DavidMolTor/ValkiriaSplit/Hardware/ValkiriaSplit.kicad_pcb

## KiCad design Hardware/ValkiriaSplit.kicad_pcb (2026-11-13)

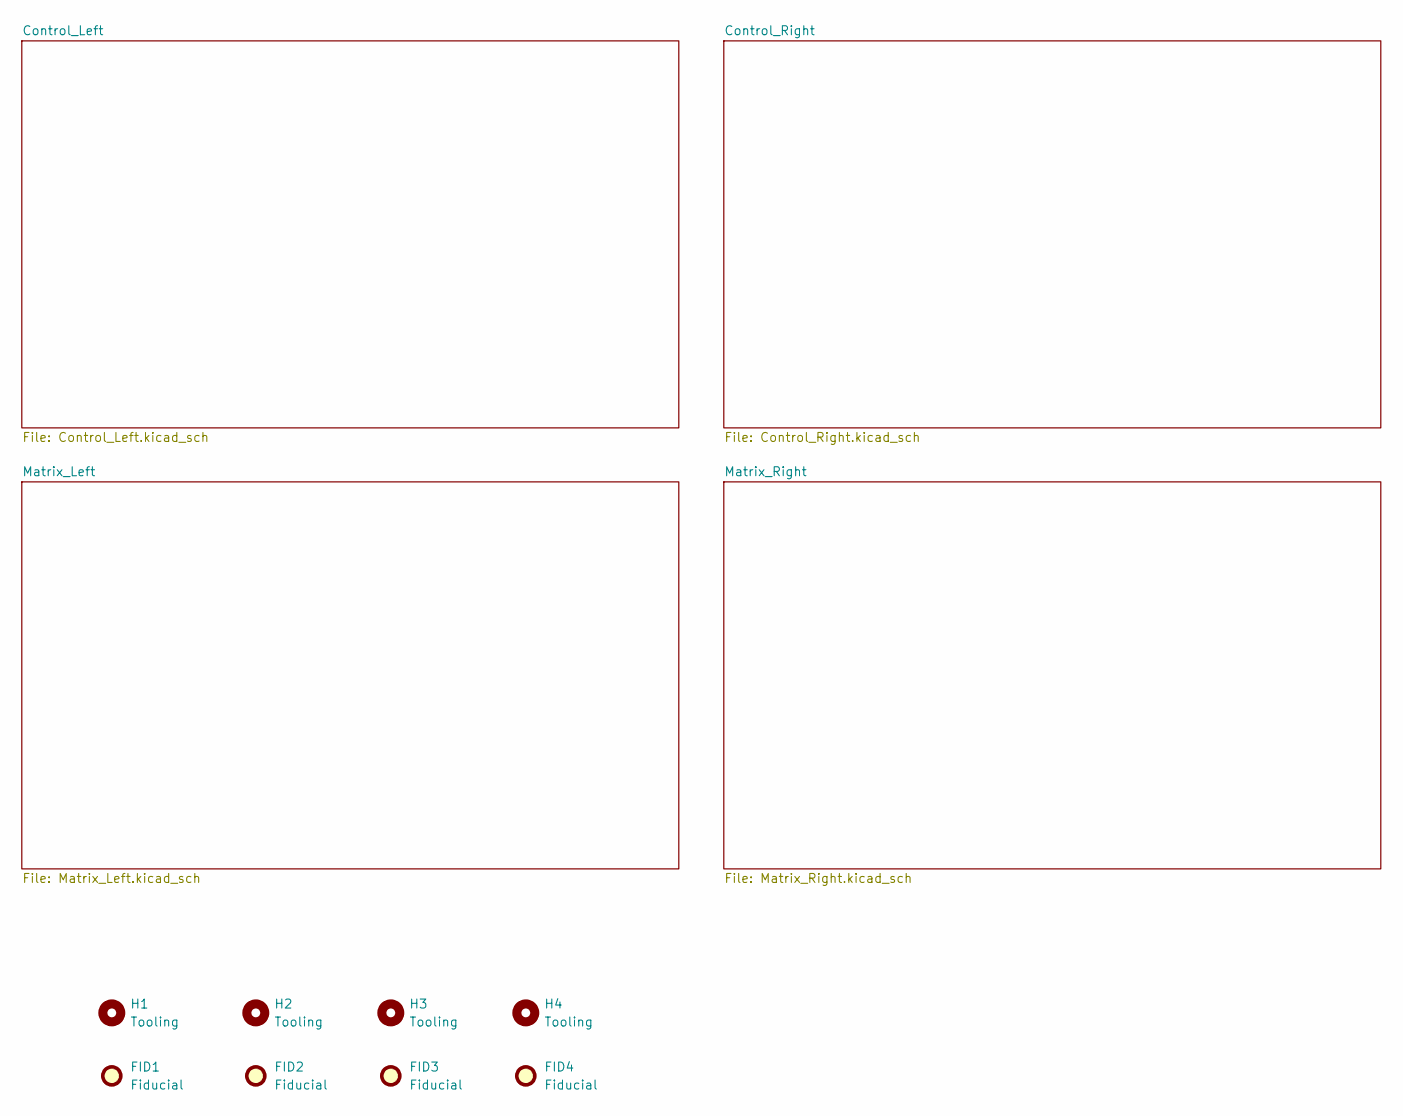
[picture p2: schematic ValkiriaSplit.kicad_sch, VALKIRIA SPLIT]

Parts:
FID1, FID2, FID3, FID4: Fiducial; Fiducial_1mm_Mask2mm
H1, H2, H3, H4: Tooling; ToolingHole_1.152mm

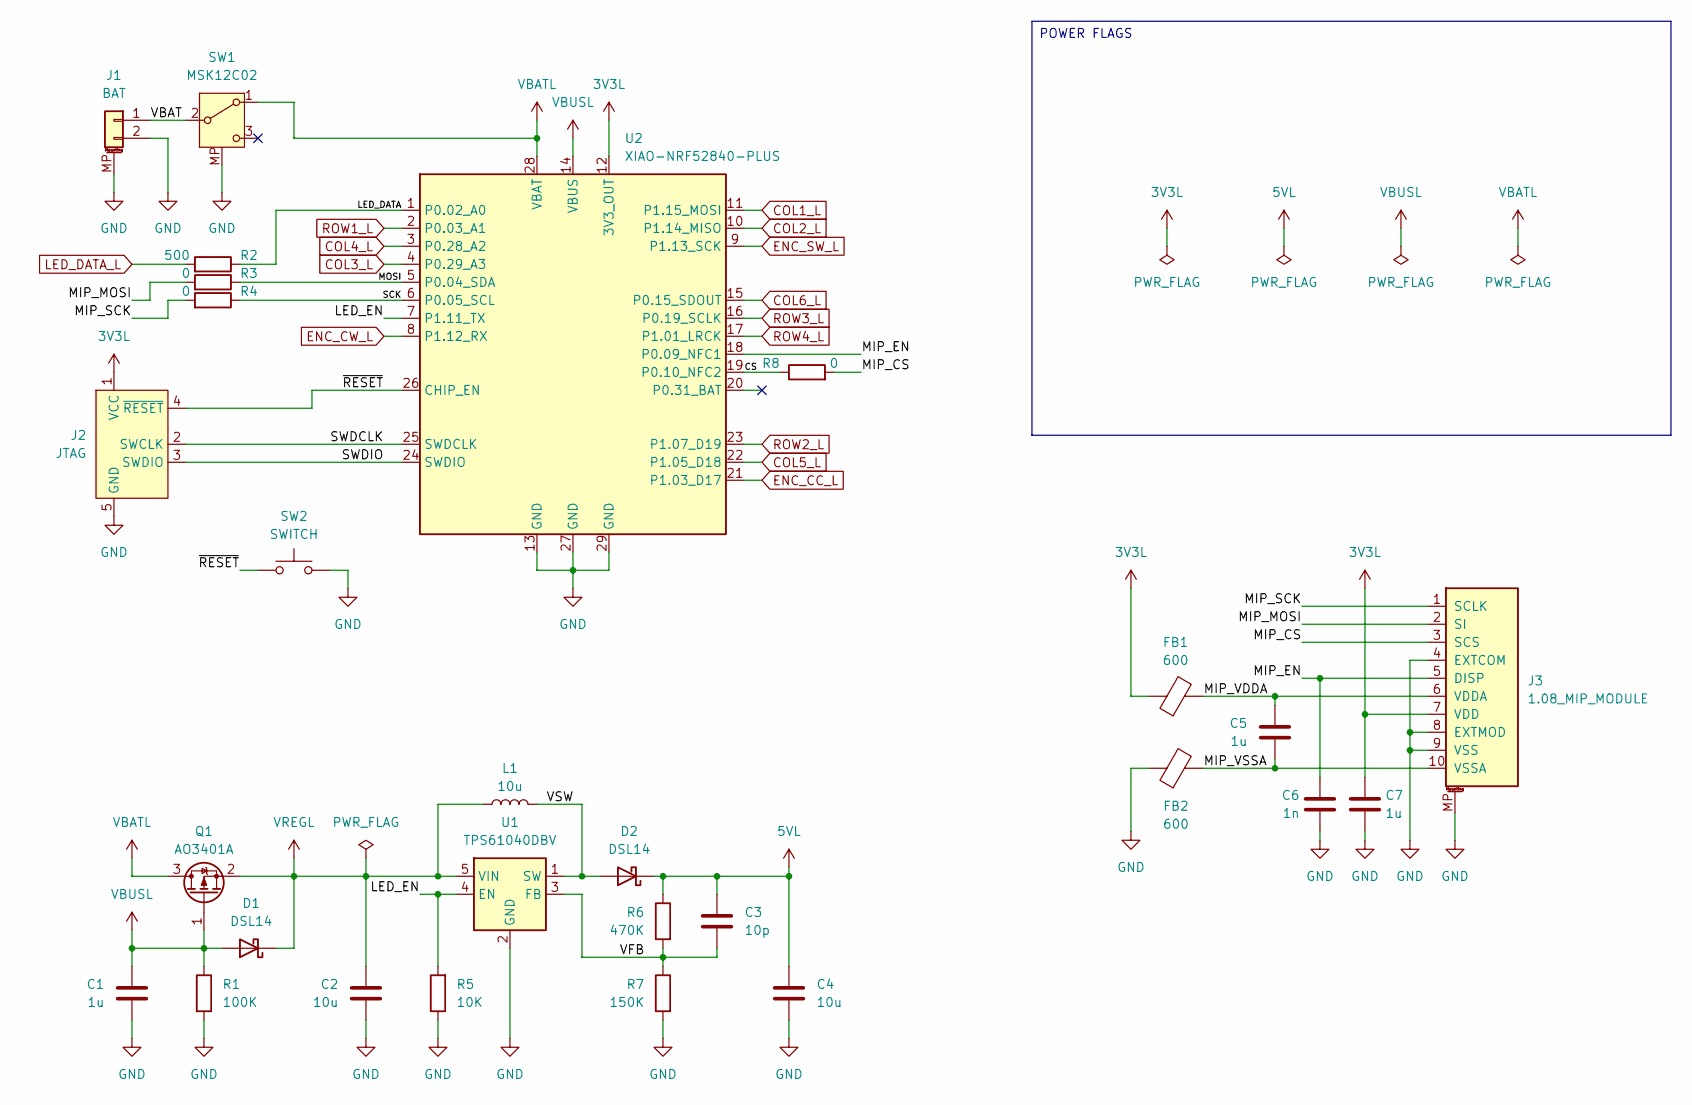
[picture p3: schematic Control_Left.kicad_sch, VALKIRIA SPLIT]

Parts:
C1, C5, C7: 1u; C_0603_1608Metric; Manufacturer Part CL10A105KB8NNNC; JLC Part C15849
C2, C4: 10u; C_0603_1608Metric; Manufacturer Part CL10A106MA8NRNC; JLC Part C96446
C3: 10p; C_0603_1608Metric; Manufacturer Part CL10C100JB8NNNC; JLC Part C1634
C6: 1n; C_0603_1608Metric; Manufacturer Part CL10B102KB8NNNC; JLC Part C1588
D1, D2: DSL14; D_SOD-123F; Manufacturer Part DSL14; JLC Part C22466349
FB1, FB2: 600; L_0603_1608Metric; Manufacturer Part GZ1608D601TF; JLC Part C1002
J1: BAT; JST_ZH_1x02_P1.50MM_SMD_HORIZONTAL; Manufacturer Part ZH1.5-2P-WT; JLC Part C722913
J2: JTAG; JTAG_SWD_1X05_1.27MM_COMBO
J3: 1.08_MIP_MODULE; 1.08_MIP_MODULE_TALL; Manufacturer Part AFC07-S10FCC-00; JLC Part C11050
L1: 10u; VLCF4020_MIRROR; Manufacturer Part NRS4018T100MDGJ; JLC Part C222882
Q1: AO3401A; SOT-23; Manufacturer Part AO3401A; JLC Part C15127
R1: 100K; R_0603_1608Metric; Manufacturer Part 0603WAF1003T5E; JLC Part C25803
R2: 500; R_0603_1608Metric; Manufacturer Part 0603WAF0000T5E; JLC Part C21189
R3, R4, R8: 0; R_0603_1608Metric; Manufacturer Part 0603WAF0000T5E; JLC Part C21189
R5: 10K; R_0603_1608Metric; Manufacturer Part 0603WAF1002T5E; JLC Part 0603WAF1002T5E
R6: 470K; R_0603_1608Metric; Manufacturer Part 0603WAF4703T5E; JLC Part C23178
R7: 150K; R_0603_1608Metric; Manufacturer Part 0603WAF1503T5E; JLC Part C22807
SW1: MSK12C02; Manufacturer Part MSK12C02-HB; JLC Part C431541
SW2: SWITCH; SW_SPST_TS-1088-xR020; Manufacturer Part TS-1088-AR02016; JLC Part C720477
U1: TPS61040DBV; SOT-23-5; Manufacturer Part TPS61040DBVR; JLC Part C7722
U2: XIAO-NRF52840-PLUS; XIAO-NRF52840-PLUS-SMD-EDGE

Connections:
3V3L: C7.1, FB1.1, J2.1 (VCC), J3.7 (VDD), U2.12 (3V3_OUT)
5VL: C3.1, C4.1, D2.1 (K), R6.1; also elsewhere on the board
/Control_Left/CS: R8.1, U2.19 (P0.10_NFC2)
/Control_Left/LED_DATA: R2.1, U2.1 (P0.02_A0)
/Control_Left/LED_EN: R5.2, U1.4 (EN), U2.7 (P1.11_TX)
/Control_Left/MIP_CS: J3.3 (SCS), R8.2
/Control_Left/MIP_EN: C6.1, J3.5 (DISP), U2.18 (P0.09_NFC1)
/Control_Left/MIP_MOSI: J3.2 (SI), R3.2
/Control_Left/MIP_SCK: J3.1 (SCLK), R4.2
/Control_Left/MIP_VDDA: C5.1, FB1.2, J3.6 (VDDA)
/Control_Left/MIP_VSSA: C5.2, FB2.2, J3.10 (VSSA)
/Control_Left/MOSI: R3.1, U2.5 (P0.04_SDA)
/Control_Left/SCK: R4.1, U2.6 (P0.05_SCL)
/Control_Left/SWDCLK: J2.2 (SWCLK), U2.25 (SWDCLK)
/Control_Left/SWDIO: J2.3 (SWDIO), U2.24 (SWDIO)
/Control_Left/VBAT: J1.1, SW1.2 (B)
/Control_Left/VFB: C3.2, R6.2, R7.1, U1.3 (FB)
/Control_Left/VSW: D2.2 (A), L1.2, U1.1 (SW)
/Control_Left/~RESET: J2.4 (~RESET), SW2.1, U2.26 (CHIP_EN)
COL1_L: U2.11 (P1.15_MOSI); also elsewhere on the board
COL2_L: U2.10 (P1.14_MISO); also elsewhere on the board
COL3_L: U2.4 (P0.29_A3); also elsewhere on the board
COL4_L: U2.3 (P0.28_A2); also elsewhere on the board
COL5_L: U2.22 (P1.05_D18); also elsewhere on the board
COL6_L: U2.15 (P0.15_SDOUT); also elsewhere on the board
ENC_CC_L: U2.21 (P1.03_D17); also elsewhere on the board
ENC_CW_L: U2.8 (P1.12_RX); also elsewhere on the board
ENC_SW_L: U2.9 (P1.13_SCK); also elsewhere on the board
GND: C1.2, C2.2, C4.2, C6.2, C7.2, FB2.1, J1.2, J1.MP (MountPin), J2.5 (GND), J3.4 (EXTCOM), J3.8 (EXTMOD), J3.9 (VSS), J3.MP, R1.2, R5.1, R7.2, SW1.MP, SW2.2, U1.2 (GND), U2.13 (GND), U2.27 (GND), U2.29 (GND); also elsewhere on the board
LED_DATA_L: R2.2; also elsewhere on the board
ROW1_L: U2.2 (P0.03_A1); also elsewhere on the board
ROW2_L: U2.23 (P1.07_D19); also elsewhere on the board
ROW3_L: U2.16 (P0.19_SCLK); also elsewhere on the board
ROW4_L: U2.17 (P1.01_LRCK); also elsewhere on the board
VBATL: Q1.3 (D), SW1.1 (A), U2.28 (VBAT)
VBUSL: C1.1, D1.2 (A), Q1.1 (G), R1.1, U2.14 (VBUS)
VREGL: C2.1, D1.1 (K), L1.1, Q1.2 (S), U1.5 (VIN)

Notes on the sheet:
POWER FLAGS

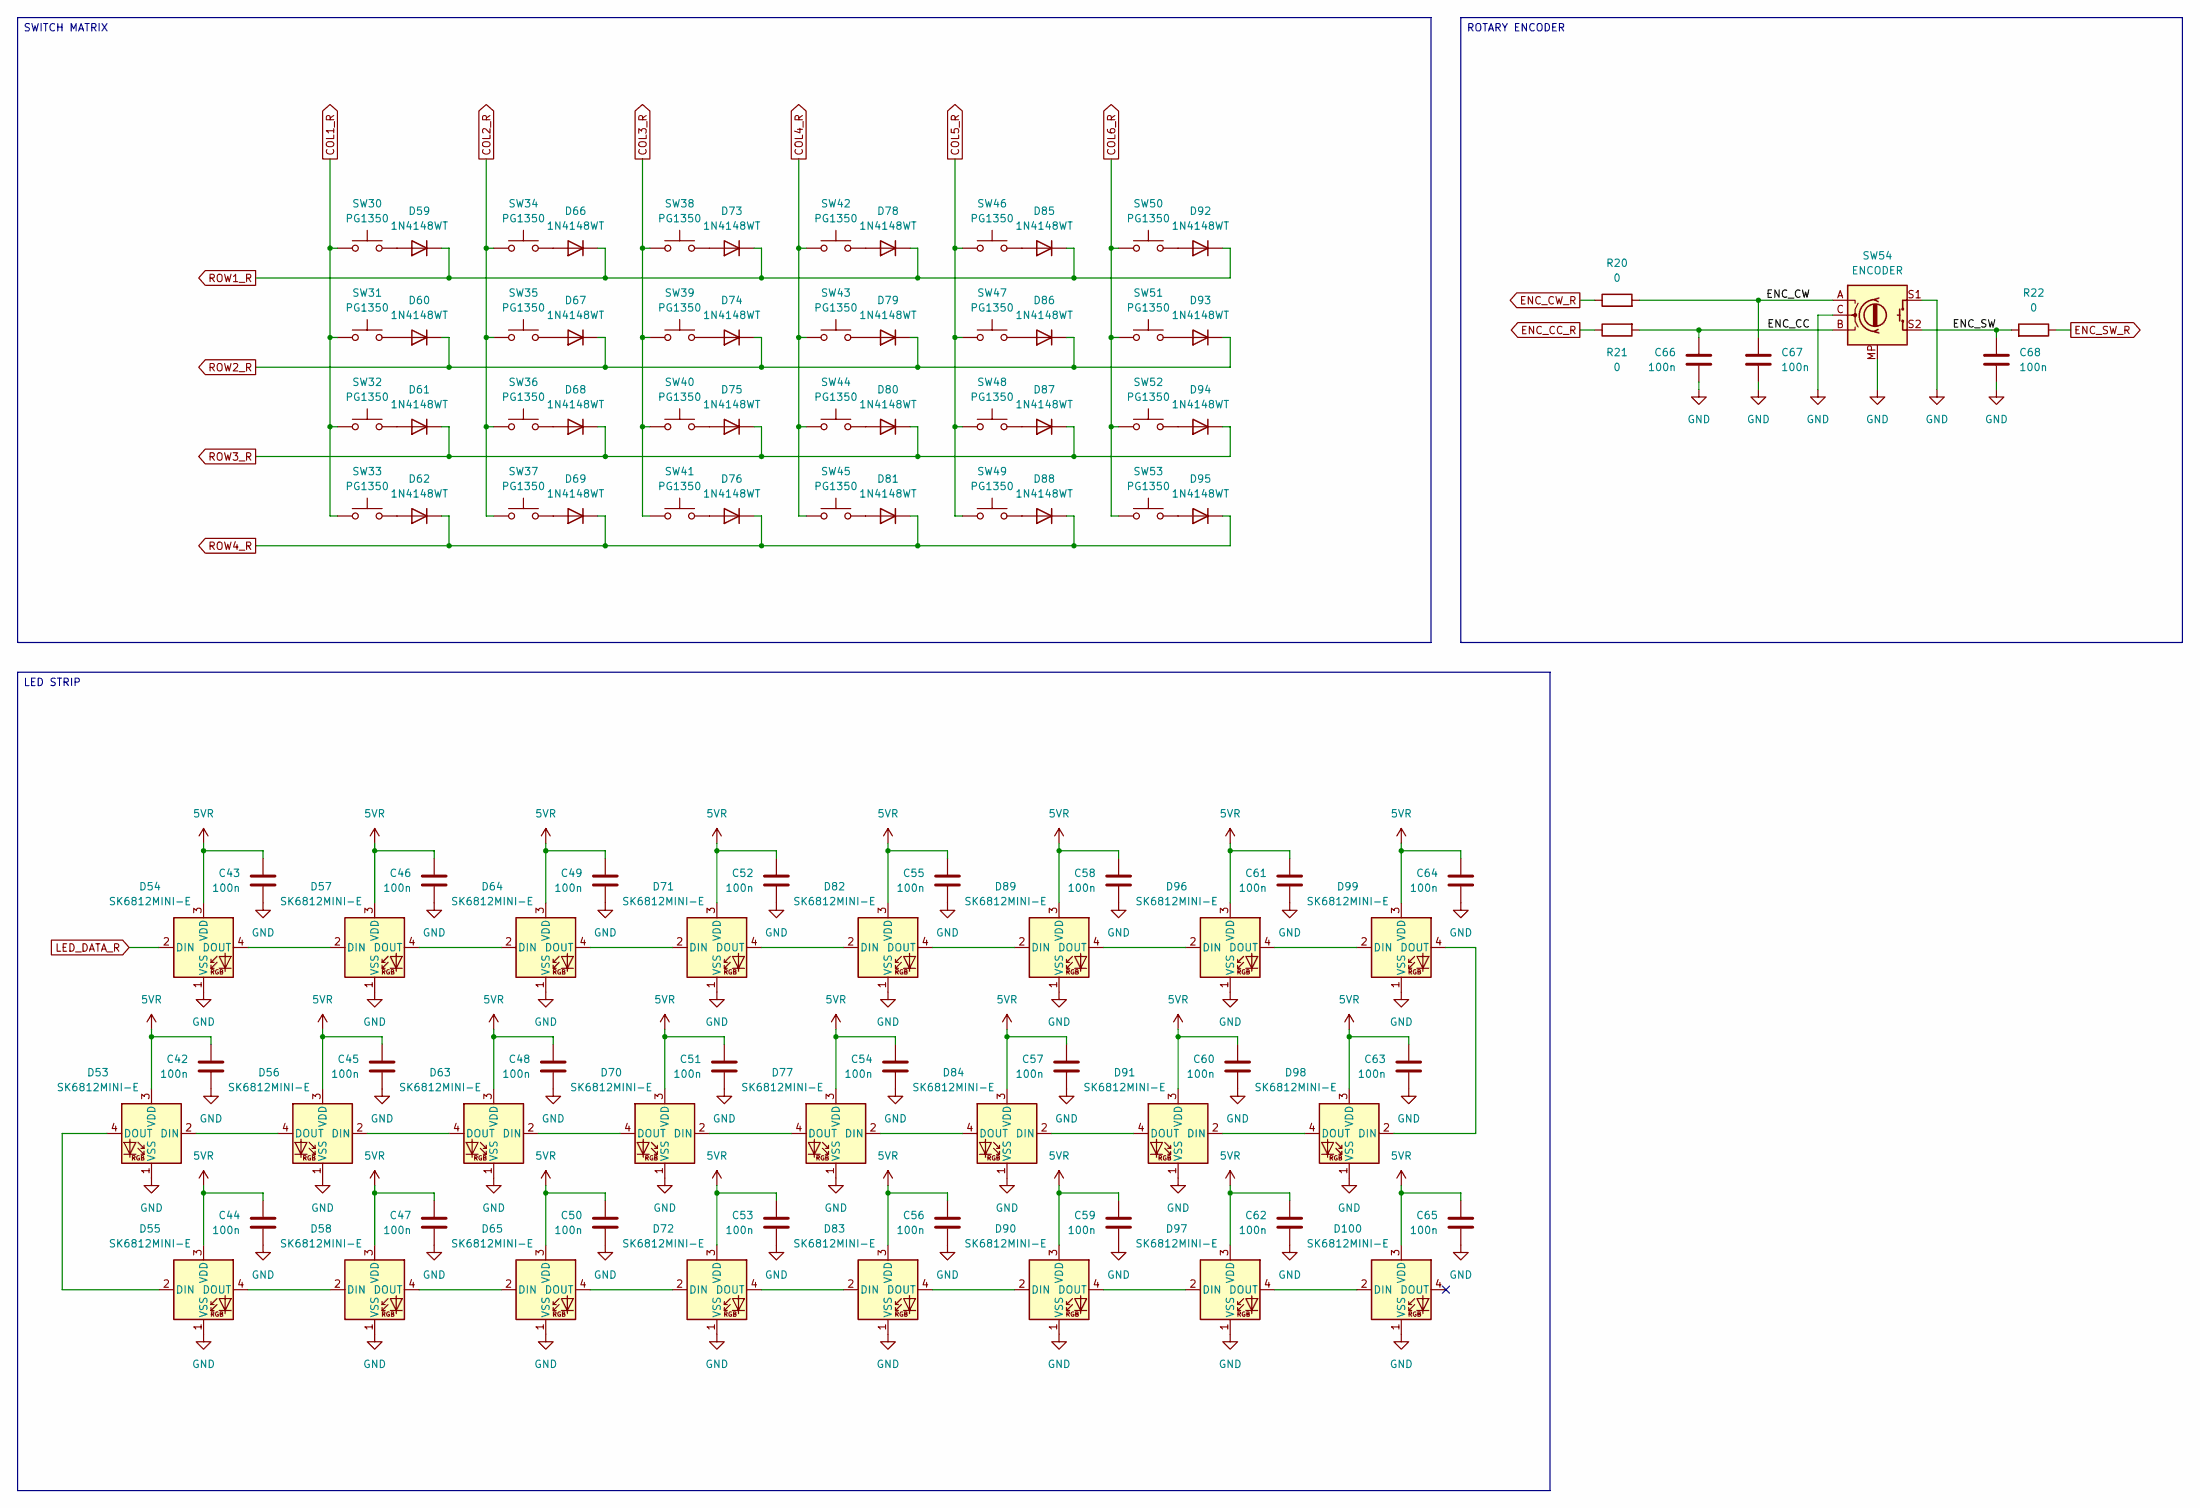
[picture p4: schematic Matrix_Right.kicad_sch, VALKIRIA SPLIT]

Parts:
C42, C43, C44, C45, C46, C47, C48, C49, C50, C51, C52, C53, C54, C55, C56, C57, C58, C59, C60, C61, C62, C63, C64, C65, C66, C67, C68: 100n; C_0603_1608Metric; Manufacturer Part CC0603KRX7R9BB104; JLC Part C14663
D53, D54, D55, D56, D57, D58, D63, D64, D65, D70, D71, D72, D77, D82, D83, D84, D89, D90, D91, D96, D97, D98, D99, D100: SK6812MINI-E; LED_SK6812MINI-E_3.2x2.8mm_P1.5mm_ReverseMount; Manufacturer Part SK6812MINI-E; JLC Part C5149201
D59, D60, D61, D62, D66, D67, D68, D69, D73, D74, D75, D76, D78, D79, D80, D81, D85, D86, D87, D88, D92, D93, D94, D95: 1N4148WT; D_SOD-523; Manufacturer Part 1N4148WT; JLC Part C7420320
R20, R21, R22: 0; R_0603_1608Metric; Manufacturer Part 0603WAF0000T5E; JLC Part C21189
SW30, SW31, SW32, SW33, SW34, SW35, SW36, SW37, SW38, SW39, SW40, SW41, SW42, SW43, SW44, SW45, SW46, SW47, SW48, SW49, SW50, SW51, SW52, SW53: PG1350; PG1350_1.00u_PCB_TIGHT; Manufacturer Part CPG135001S30; JLC Part C5333465
SW54: ENCODER; ALPS_EC11J_ENCODER; Manufacturer Part EC11J1525402; JLC Part C209762

Connections:
5VR: C42.1, C43.1, C44.1, C45.1, C46.1, C47.1, C48.1, C49.1, C50.1, C51.1, C52.1, C53.1, C54.1, C55.1, C56.1, C57.1, C58.1, C59.1, C60.1, C61.1, C62.1, C63.1, C64.1, C65.1, D53.3 (VDD), D54.3 (VDD), D55.3 (VDD), D56.3 (VDD), D57.3 (VDD), D58.3 (VDD), D63.3 (VDD), D64.3 (VDD), D65.3 (VDD), D70.3 (VDD), D71.3 (VDD), D72.3 (VDD), D77.3 (VDD), D82.3 (VDD), D83.3 (VDD), D84.3 (VDD), D89.3 (VDD), D90.3 (VDD), D91.3 (VDD), D96.3 (VDD), D97.3 (VDD), D98.3 (VDD), D99.3 (VDD), D100.3 (VDD); also elsewhere on the board
/Matrix_Right/ENC_CC: C66.1, R21.2, SW54.B
/Matrix_Right/ENC_CW: C67.1, R20.2, SW54.A
/Matrix_Right/ENC_SW: C68.1, R22.2, SW54.S2
COL1_R: SW30.1, SW31.1, SW32.1, SW33.1; also elsewhere on the board
COL2_R: SW34.1, SW35.1, SW36.1, SW37.1; also elsewhere on the board
COL3_R: SW38.1, SW39.1, SW40.1, SW41.1; also elsewhere on the board
COL4_R: SW42.1, SW43.1, SW44.1, SW45.1; also elsewhere on the board
COL5_R: SW46.1, SW47.1, SW48.1, SW49.1; also elsewhere on the board
COL6_R: SW50.1, SW51.1, SW52.1, SW53.1; also elsewhere on the board
ENC_CC_R: R21.1; also elsewhere on the board
ENC_CW_R: R20.1; also elsewhere on the board
ENC_SW_R: R22.1; also elsewhere on the board
GND: C42.2, C43.2, C44.2, C45.2, C46.2, C47.2, C48.2, C49.2, C50.2, C51.2, C52.2, C53.2, C54.2, C55.2, C56.2, C57.2, C58.2, C59.2, C60.2, C61.2, C62.2, C63.2, C64.2, C65.2, C66.2, C67.2, C68.2, D53.1 (VSS), D54.1 (VSS), D55.1 (VSS), D56.1 (VSS), D57.1 (VSS), D58.1 (VSS), D63.1 (VSS), D64.1 (VSS), D65.1 (VSS), D70.1 (VSS), D71.1 (VSS), D72.1 (VSS), D77.1 (VSS), D82.1 (VSS), D83.1 (VSS), D84.1 (VSS), D89.1 (VSS), D90.1 (VSS), D91.1 (VSS), D96.1 (VSS), D97.1 (VSS), D98.1 (VSS), D99.1 (VSS), D100.1 (VSS), SW54.C, SW54.MP, SW54.S1; also elsewhere on the board
LED_DATA_R: D54.2 (DIN); also elsewhere on the board
unnamed: D53.2 (DIN), D56.4 (DOUT)
unnamed: D53.4 (DOUT), D55.2 (DIN)
unnamed: D54.4 (DOUT), D57.2 (DIN)
unnamed: D55.4 (DOUT), D58.2 (DIN)
unnamed: D56.2 (DIN), D63.4 (DOUT)
unnamed: D57.4 (DOUT), D64.2 (DIN)
unnamed: D58.4 (DOUT), D65.2 (DIN)
unnamed: D59.2 (A), SW30.2
unnamed: D60.2 (A), SW31.2
unnamed: D61.2 (A), SW32.2
unnamed: D62.2 (A), SW33.2
unnamed: D63.2 (DIN), D70.4 (DOUT)
unnamed: D64.4 (DOUT), D71.2 (DIN)
unnamed: D65.4 (DOUT), D72.2 (DIN)
unnamed: D66.2 (A), SW34.2
unnamed: D67.2 (A), SW35.2
unnamed: D68.2 (A), SW36.2
unnamed: D69.2 (A), SW37.2
unnamed: D70.2 (DIN), D77.4 (DOUT)
unnamed: D71.4 (DOUT), D82.2 (DIN)
unnamed: D72.4 (DOUT), D83.2 (DIN)
unnamed: D73.2 (A), SW38.2
unnamed: D74.2 (A), SW39.2
unnamed: D75.2 (A), SW40.2
unnamed: D76.2 (A), SW41.2
unnamed: D77.2 (DIN), D84.4 (DOUT)
unnamed: D78.2 (A), SW42.2
unnamed: D79.2 (A), SW43.2
unnamed: D80.2 (A), SW44.2
unnamed: D81.2 (A), SW45.2
unnamed: D82.4 (DOUT), D89.2 (DIN)
unnamed: D83.4 (DOUT), D90.2 (DIN)
unnamed: D84.2 (DIN), D91.4 (DOUT)
unnamed: D85.2 (A), SW46.2
unnamed: D86.2 (A), SW47.2
unnamed: D87.2 (A), SW48.2
unnamed: D88.2 (A), SW49.2
unnamed: D89.4 (DOUT), D96.2 (DIN)
unnamed: D90.4 (DOUT), D97.2 (DIN)
unnamed: D91.2 (DIN), D98.4 (DOUT)
unnamed: D92.2 (A), SW50.2
unnamed: D93.2 (A), SW51.2
unnamed: D94.2 (A), SW52.2
unnamed: D95.2 (A), SW53.2
unnamed: D96.4 (DOUT), D99.2 (DIN)
unnamed: D98.2 (DIN), D99.4 (DOUT)
unnamed: D97.4 (DOUT), D100.2 (DIN)
ROW1_R: D59.1 (K), D66.1 (K), D73.1 (K), D78.1 (K), D85.1 (K), D92.1 (K); also elsewhere on the board
ROW2_R: D60.1 (K), D67.1 (K), D74.1 (K), D79.1 (K), D86.1 (K), D93.1 (K); also elsewhere on the board
ROW3_R: D61.1 (K), D68.1 (K), D75.1 (K), D80.1 (K), D87.1 (K), D94.1 (K); also elsewhere on the board
ROW4_R: D62.1 (K), D69.1 (K), D76.1 (K), D81.1 (K), D88.1 (K), D95.1 (K); also elsewhere on the board

Notes on the sheet:
SWITCH MATRIX
ROTARY ENCODER
LED STRIP

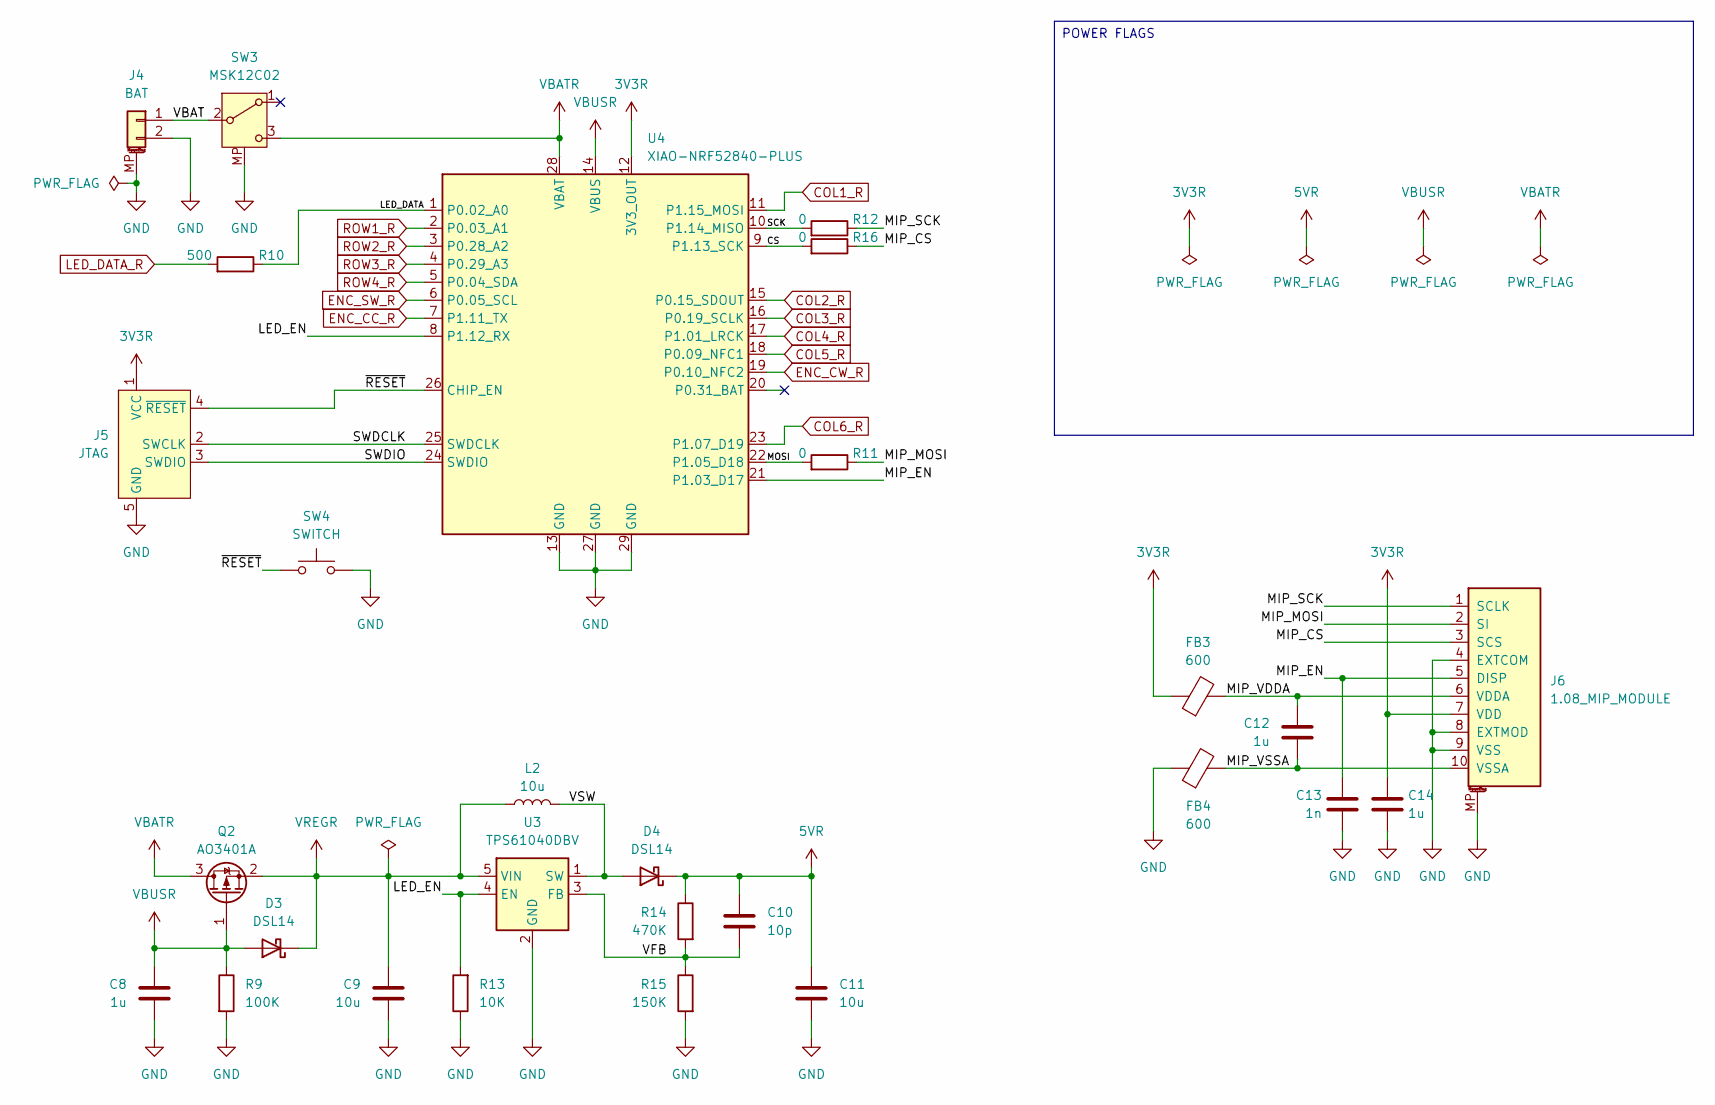
[picture p5: schematic Control_Right.kicad_sch, VALKIRIA SPLIT]

Parts:
C8, C12, C14: 1u; C_0603_1608Metric; Manufacturer Part CL10A105KB8NNNC; JLC Part C15849
C9, C11: 10u; C_0603_1608Metric; Manufacturer Part CL10A106MA8NRNC; JLC Part C96446
C10: 10p; C_0603_1608Metric; Manufacturer Part CL10C100JB8NNNC; JLC Part C1634
C13: 1n; C_0603_1608Metric; Manufacturer Part CL10B102KB8NNNC; JLC Part C1588
D3, D4: DSL14; D_SOD-123F; Manufacturer Part DSL14; JLC Part C22466349
FB3, FB4: 600; L_0603_1608Metric; Manufacturer Part GZ1608D601TF; JLC Part C1002
J4: BAT; JST_ZH_1x02_P1.50MM_SMD_HORIZONTAL; Manufacturer Part ZH1.5-2P-WT; JLC Part C722913
J5: JTAG; JTAG_SWD_1X05_1.27MM_COMBO
J6: 1.08_MIP_MODULE; 1.08_MIP_MODULE_TALL; Manufacturer Part AFC07-S10FCC-00; JLC Part C11050
L2: 10u; VLCF4020_MIRROR; Manufacturer Part NRS4018T100MDGJ; JLC Part C222882
Q2: AO3401A; SOT-23; Manufacturer Part AO3401A; JLC Part C15127
R9: 100K; R_0603_1608Metric; Manufacturer Part 0603WAF1003T5E; JLC Part C25803
R10: 500; R_0603_1608Metric; Manufacturer Part 0603WAF0000T5E; JLC Part C21189
R11, R12, R16: 0; R_0603_1608Metric; Manufacturer Part 0603WAF0000T5E; JLC Part C21189
R13: 10K; R_0603_1608Metric; Manufacturer Part 0603WAF1002T5E; JLC Part 0603WAF1002T5E
R14: 470K; R_0603_1608Metric; Manufacturer Part 0603WAF4703T5E; JLC Part C23178
R15: 150K; R_0603_1608Metric; Manufacturer Part 0603WAF1503T5E; JLC Part C22807
SW3: MSK12C02; Manufacturer Part MSK12C02-HB; JLC Part C431541
SW4: SWITCH; SW_SPST_TS-1088-xR020; Manufacturer Part TS-1088-AR02016; JLC Part C720477
U3: TPS61040DBV; SOT-23-5; Manufacturer Part TPS61040DBVR; JLC Part C7722
U4: XIAO-NRF52840-PLUS; XIAO-NRF52840-PLUS-SMD-EDGE

Connections:
3V3R: C14.1, FB3.1, J5.1 (VCC), J6.7 (VDD), U4.12 (3V3_OUT)
5VR: C10.1, C11.1, D4.1 (K), R14.1; also elsewhere on the board
/Control_Right/CS: R16.2, U4.9 (P1.13_SCK)
/Control_Right/LED_DATA: R10.1, U4.1 (P0.02_A0)
/Control_Right/LED_EN: R13.2, U3.4 (EN), U4.8 (P1.12_RX)
/Control_Right/MIP_CS: J6.3 (SCS), R16.1
/Control_Right/MIP_EN: C13.1, J6.5 (DISP), U4.21 (P1.03_D17)
/Control_Right/MIP_MOSI: J6.2 (SI), R11.1
/Control_Right/MIP_SCK: J6.1 (SCLK), R12.1
/Control_Right/MIP_VDDA: C12.1, FB3.2, J6.6 (VDDA)
/Control_Right/MIP_VSSA: C12.2, FB4.2, J6.10 (VSSA)
/Control_Right/MOSI: R11.2, U4.22 (P1.05_D18)
/Control_Right/SCK: R12.2, U4.10 (P1.14_MISO)
/Control_Right/SWDCLK: J5.2 (SWCLK), U4.25 (SWDCLK)
/Control_Right/SWDIO: J5.3 (SWDIO), U4.24 (SWDIO)
/Control_Right/VBAT: J4.1, SW3.2 (B)
/Control_Right/VFB: C10.2, R14.2, R15.1, U3.3 (FB)
/Control_Right/VSW: D4.2 (A), L2.2, U3.1 (SW)
/Control_Right/~RESET: J5.4 (~RESET), SW4.1, U4.26 (CHIP_EN)
COL1_R: U4.11 (P1.15_MOSI); also elsewhere on the board
COL2_R: U4.15 (P0.15_SDOUT); also elsewhere on the board
COL3_R: U4.16 (P0.19_SCLK); also elsewhere on the board
COL4_R: U4.17 (P1.01_LRCK); also elsewhere on the board
COL5_R: U4.18 (P0.09_NFC1); also elsewhere on the board
COL6_R: U4.23 (P1.07_D19); also elsewhere on the board
ENC_CC_R: U4.7 (P1.11_TX); also elsewhere on the board
ENC_CW_R: U4.19 (P0.10_NFC2); also elsewhere on the board
ENC_SW_R: U4.6 (P0.05_SCL); also elsewhere on the board
GND: C8.2, C9.2, C11.2, C13.2, C14.2, FB4.1, J4.2, J4.MP (MountPin), J5.5 (GND), J6.4 (EXTCOM), J6.8 (EXTMOD), J6.9 (VSS), J6.MP, R9.2, R13.1, R15.2, SW3.MP, SW4.2, U3.2 (GND), U4.13 (GND), U4.27 (GND), U4.29 (GND); also elsewhere on the board
LED_DATA_R: R10.2; also elsewhere on the board
ROW1_R: U4.2 (P0.03_A1); also elsewhere on the board
ROW2_R: U4.3 (P0.28_A2); also elsewhere on the board
ROW3_R: U4.4 (P0.29_A3); also elsewhere on the board
ROW4_R: U4.5 (P0.04_SDA); also elsewhere on the board
VBATR: Q2.3 (D), SW3.3 (C), U4.28 (VBAT)
VBUSR: C8.1, D3.2 (A), Q2.1 (G), R9.1, U4.14 (VBUS)
VREGR: C9.1, D3.1 (K), L2.1, Q2.2 (S), U3.5 (VIN)

Notes on the sheet:
POWER FLAGS

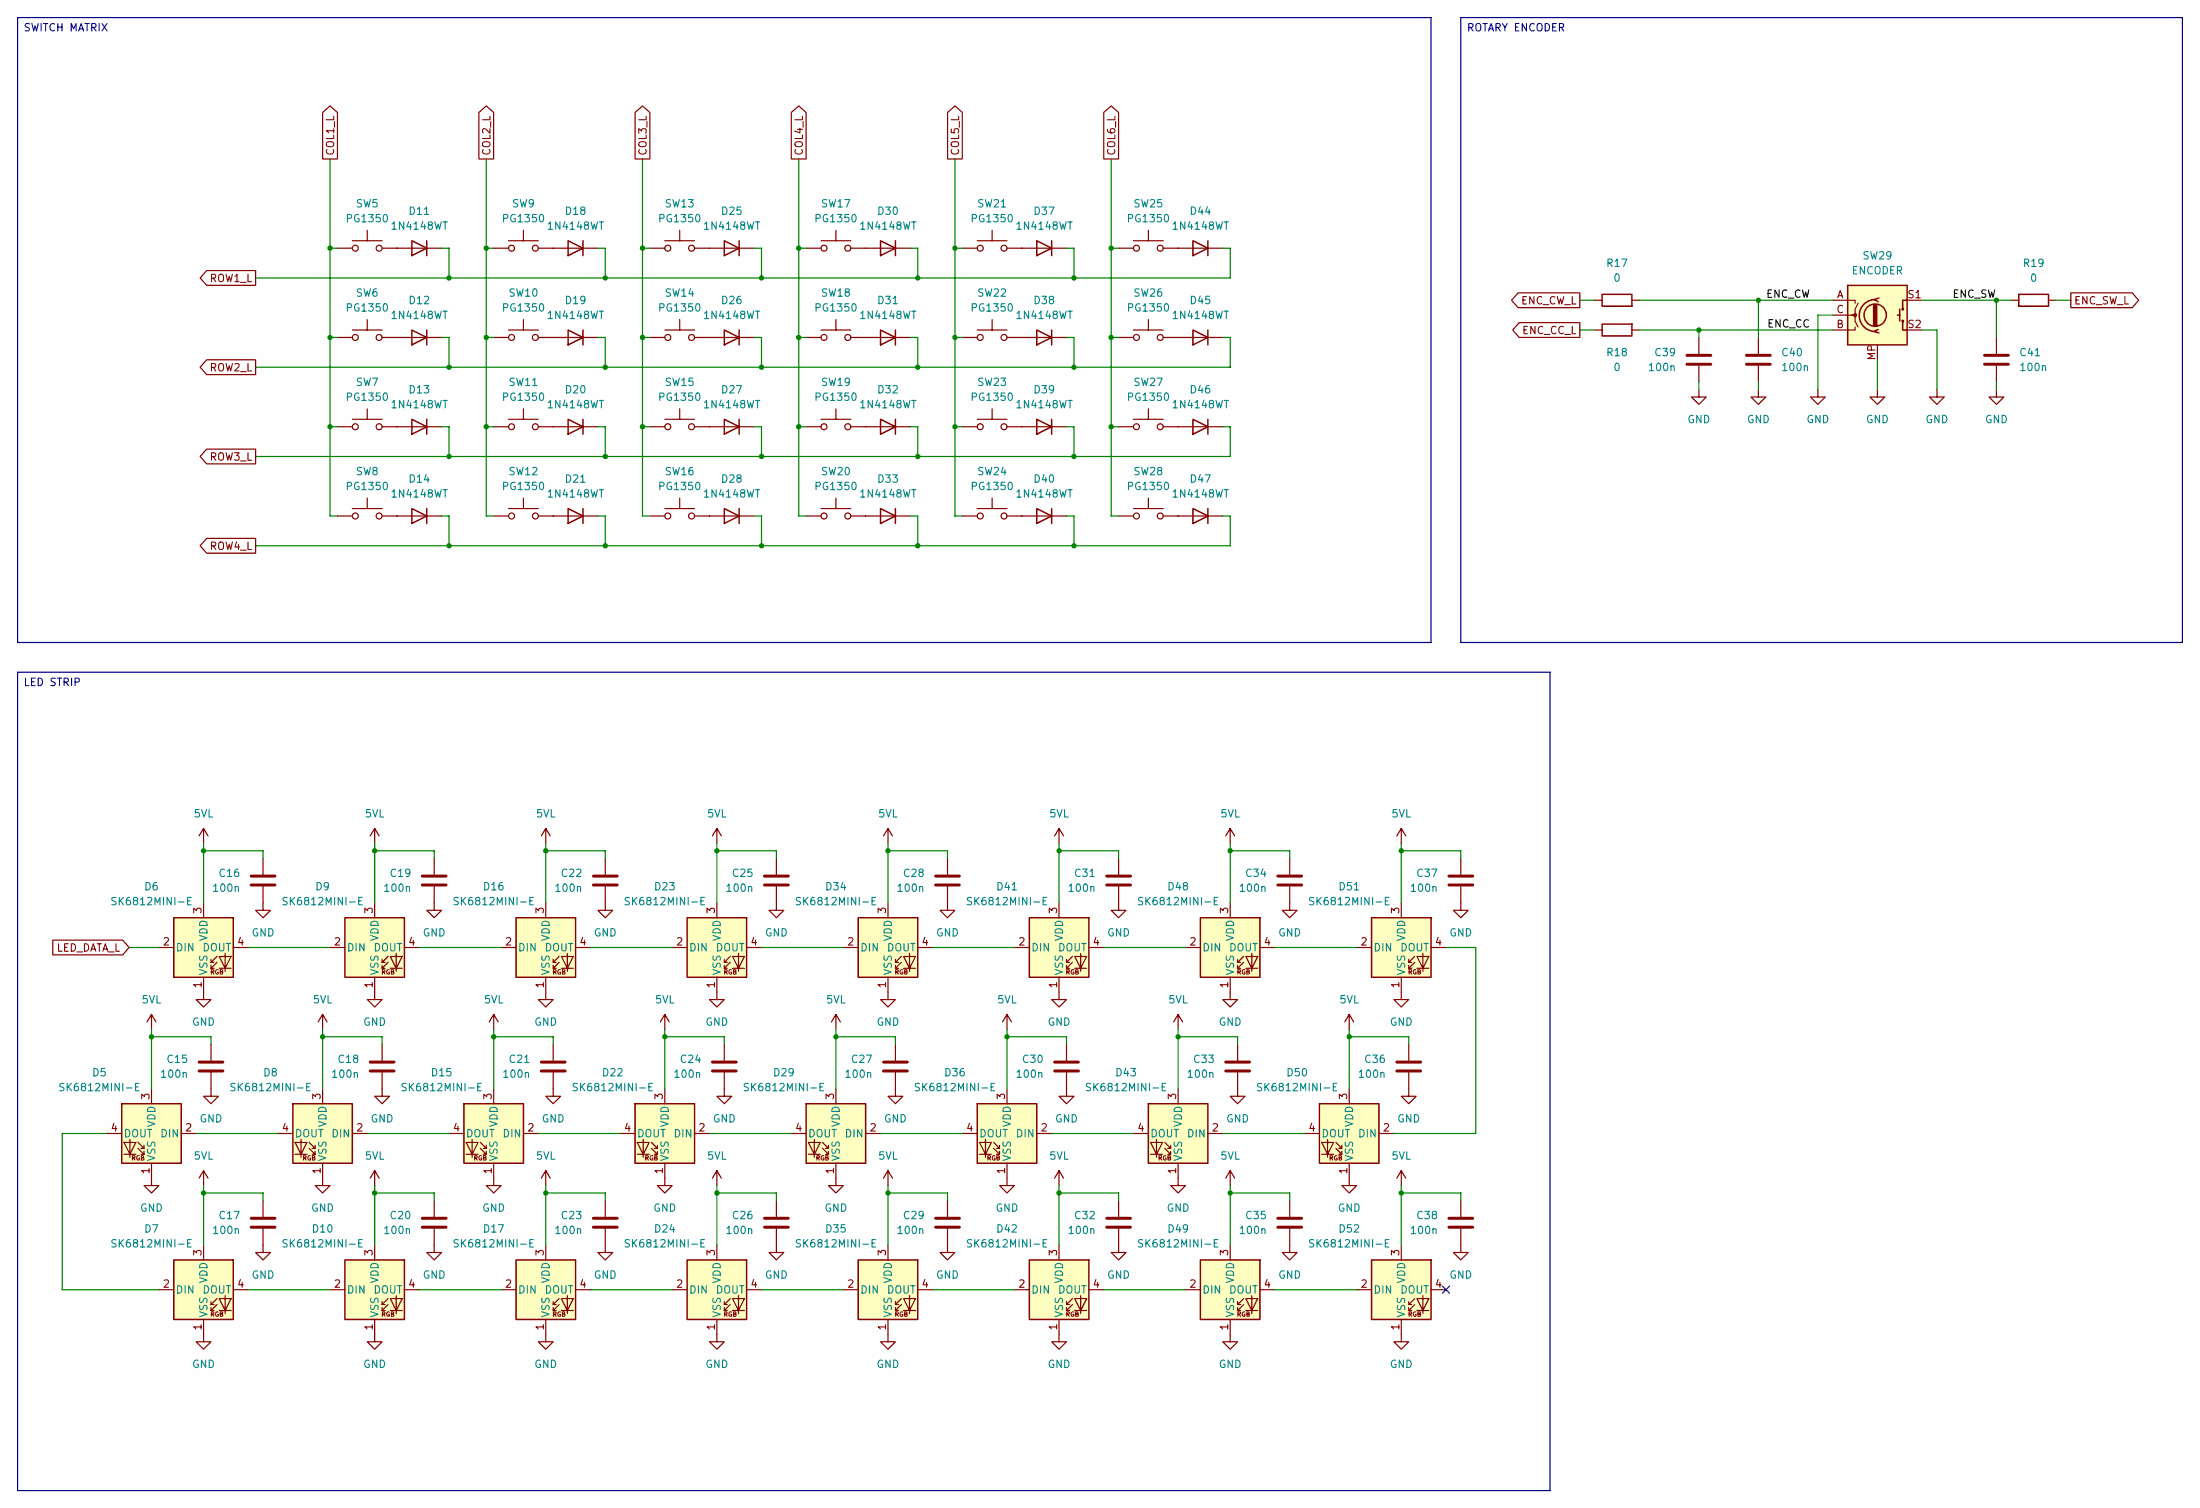
[picture p6: schematic Matrix_Left.kicad_sch, VALKIRIA SPLIT]

Parts:
C15, C16, C17, C18, C19, C20, C21, C22, C23, C24, C25, C26, C27, C28, C29, C30, C31, C32, C33, C34, C35, C36, C37, C38, C39, C40, C41: 100n; C_0603_1608Metric; Manufacturer Part CC0603KRX7R9BB104; JLC Part C14663
D5, D6, D7, D8, D9, D10, D15, D16, D17, D22, D23, D24, D29, D34, D35, D36, D41, D42, D43, D48, D49, D50, D51, D52: SK6812MINI-E; LED_SK6812MINI-E_3.2x2.8mm_P1.5mm_ReverseMount; Manufacturer Part SK6812MINI-E; JLC Part C5149201
D11, D12, D13, D14, D18, D19, D20, D21, D25, D26, D27, D28, D30, D31, D32, D33, D37, D38, D39, D40, D44, D45, D46, D47: 1N4148WT; D_SOD-523; Manufacturer Part 1N4148WT; JLC Part C7420320
R17, R18, R19: 0; R_0603_1608Metric; Manufacturer Part 0603WAF0000T5E; JLC Part C21189
SW5, SW6, SW7, SW8, SW9, SW10, SW11, SW12, SW13, SW14, SW15, SW16, SW17, SW18, SW19, SW20, SW21, SW22, SW23, SW24, SW25, SW26, SW27, SW28: PG1350; PG1350_1.00u_PCB_TIGHT; Manufacturer Part CPG135001S30; JLC Part C5333465
SW29: ENCODER; ALPS_EC11J_ENCODER; Manufacturer Part EC11J1525402; JLC Part C209762

Connections:
5VL: C15.1, C16.1, C17.1, C18.1, C19.1, C20.1, C21.1, C22.1, C23.1, C24.1, C25.1, C26.1, C27.1, C28.1, C29.1, C30.1, C31.1, C32.1, C33.1, C34.1, C35.1, C36.1, C37.1, C38.1, D5.3 (VDD), D6.3 (VDD), D7.3 (VDD), D8.3 (VDD), D9.3 (VDD), D10.3 (VDD), D15.3 (VDD), D16.3 (VDD), D17.3 (VDD), D22.3 (VDD), D23.3 (VDD), D24.3 (VDD), D29.3 (VDD), D34.3 (VDD), D35.3 (VDD), D36.3 (VDD), D41.3 (VDD), D42.3 (VDD), D43.3 (VDD), D48.3 (VDD), D49.3 (VDD), D50.3 (VDD), D51.3 (VDD), D52.3 (VDD); also elsewhere on the board
/Matrix_Left/ENC_CC: C39.1, R18.2, SW29.B
/Matrix_Left/ENC_CW: C40.1, R17.2, SW29.A
/Matrix_Left/ENC_SW: C41.1, R19.2, SW29.S1
COL1_L: SW5.1, SW6.1, SW7.1, SW8.1; also elsewhere on the board
COL2_L: SW9.1, SW10.1, SW11.1, SW12.1; also elsewhere on the board
COL3_L: SW13.1, SW14.1, SW15.1, SW16.1; also elsewhere on the board
COL4_L: SW17.1, SW18.1, SW19.1, SW20.1; also elsewhere on the board
COL5_L: SW21.1, SW22.1, SW23.1, SW24.1; also elsewhere on the board
COL6_L: SW25.1, SW26.1, SW27.1, SW28.1; also elsewhere on the board
ENC_CC_L: R18.1; also elsewhere on the board
ENC_CW_L: R17.1; also elsewhere on the board
ENC_SW_L: R19.1; also elsewhere on the board
GND: C15.2, C16.2, C17.2, C18.2, C19.2, C20.2, C21.2, C22.2, C23.2, C24.2, C25.2, C26.2, C27.2, C28.2, C29.2, C30.2, C31.2, C32.2, C33.2, C34.2, C35.2, C36.2, C37.2, C38.2, C39.2, C40.2, C41.2, D5.1 (VSS), D6.1 (VSS), D7.1 (VSS), D8.1 (VSS), D9.1 (VSS), D10.1 (VSS), D15.1 (VSS), D16.1 (VSS), D17.1 (VSS), D22.1 (VSS), D23.1 (VSS), D24.1 (VSS), D29.1 (VSS), D34.1 (VSS), D35.1 (VSS), D36.1 (VSS), D41.1 (VSS), D42.1 (VSS), D43.1 (VSS), D48.1 (VSS), D49.1 (VSS), D50.1 (VSS), D51.1 (VSS), D52.1 (VSS), SW29.C, SW29.MP, SW29.S2; also elsewhere on the board
LED_DATA_L: D6.2 (DIN); also elsewhere on the board
unnamed: D5.2 (DIN), D8.4 (DOUT)
unnamed: D5.4 (DOUT), D7.2 (DIN)
unnamed: D6.4 (DOUT), D9.2 (DIN)
unnamed: D7.4 (DOUT), D10.2 (DIN)
unnamed: D10.4 (DOUT), D17.2 (DIN)
unnamed: D11.2 (A), SW5.2
unnamed: D12.2 (A), SW6.2
unnamed: D13.2 (A), SW7.2
unnamed: D14.2 (A), SW8.2
unnamed: D15.2 (DIN), D22.4 (DOUT)
unnamed: D8.2 (DIN), D15.4 (DOUT)
unnamed: D9.4 (DOUT), D16.2 (DIN)
unnamed: D16.4 (DOUT), D23.2 (DIN)
unnamed: D17.4 (DOUT), D24.2 (DIN)
unnamed: D18.2 (A), SW9.2
unnamed: D19.2 (A), SW10.2
unnamed: D20.2 (A), SW11.2
unnamed: D21.2 (A), SW12.2
unnamed: D22.2 (DIN), D29.4 (DOUT)
unnamed: D23.4 (DOUT), D34.2 (DIN)
unnamed: D24.4 (DOUT), D35.2 (DIN)
unnamed: D25.2 (A), SW13.2
unnamed: D26.2 (A), SW14.2
unnamed: D27.2 (A), SW15.2
unnamed: D28.2 (A), SW16.2
unnamed: D29.2 (DIN), D36.4 (DOUT)
unnamed: D30.2 (A), SW17.2
unnamed: D31.2 (A), SW18.2
unnamed: D32.2 (A), SW19.2
unnamed: D33.2 (A), SW20.2
unnamed: D34.4 (DOUT), D41.2 (DIN)
unnamed: D35.4 (DOUT), D42.2 (DIN)
unnamed: D36.2 (DIN), D43.4 (DOUT)
unnamed: D37.2 (A), SW21.2
unnamed: D38.2 (A), SW22.2
unnamed: D39.2 (A), SW23.2
unnamed: D40.2 (A), SW24.2
unnamed: D41.4 (DOUT), D48.2 (DIN)
unnamed: D42.4 (DOUT), D49.2 (DIN)
unnamed: D43.2 (DIN), D50.4 (DOUT)
unnamed: D44.2 (A), SW25.2
unnamed: D45.2 (A), SW26.2
unnamed: D46.2 (A), SW27.2
unnamed: D47.2 (A), SW28.2
unnamed: D48.4 (DOUT), D51.2 (DIN)
unnamed: D49.4 (DOUT), D52.2 (DIN)
unnamed: D50.2 (DIN), D51.4 (DOUT)
ROW1_L: D11.1 (K), D18.1 (K), D25.1 (K), D30.1 (K), D37.1 (K), D44.1 (K); also elsewhere on the board
ROW2_L: D12.1 (K), D19.1 (K), D26.1 (K), D31.1 (K), D38.1 (K), D45.1 (K); also elsewhere on the board
ROW3_L: D13.1 (K), D20.1 (K), D27.1 (K), D32.1 (K), D39.1 (K), D46.1 (K); also elsewhere on the board
ROW4_L: D14.1 (K), D21.1 (K), D28.1 (K), D33.1 (K), D40.1 (K), D47.1 (K); also elsewhere on the board

Notes on the sheet:
LED STRIP
ROTARY ENCODER
SWITCH MATRIX
