DavidMolTor/ValkiriaSplit/Hardware/ValkiriaSplit.kicad_pcb

## KiCad design Hardware/ValkiriaSplit.kicad_pcb (continued)

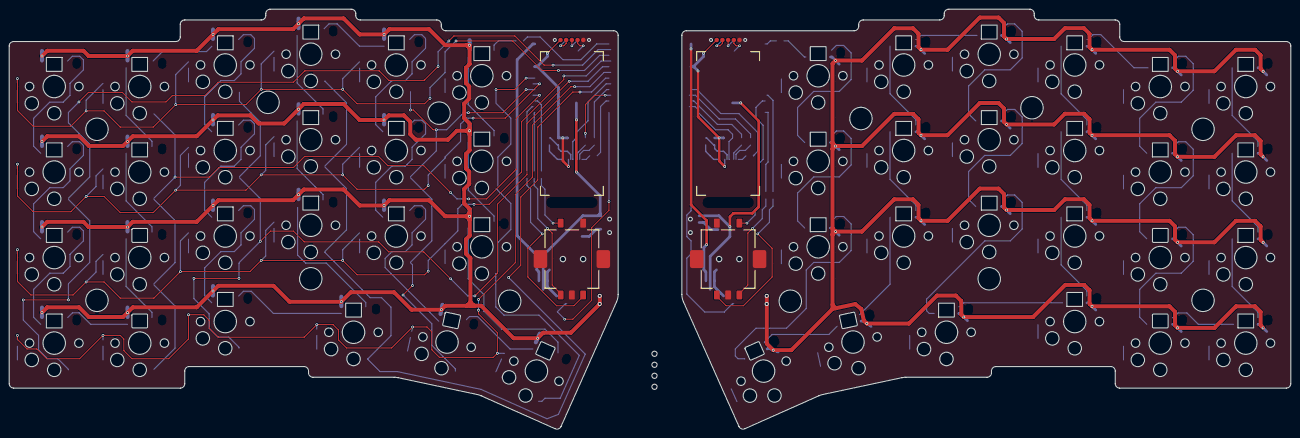
[picture p7: board ValkiriaSplit.kicad_pcb from above]

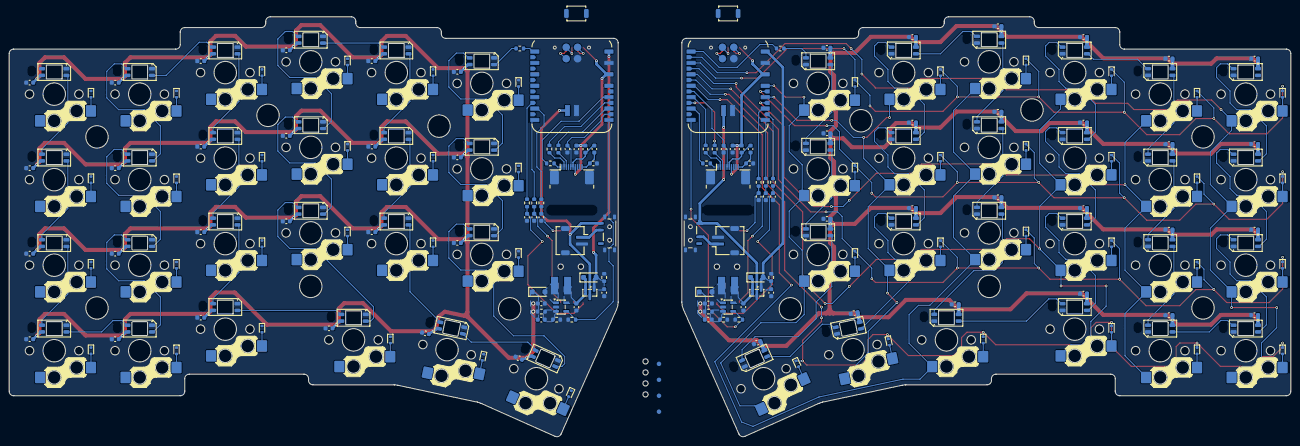
[picture p8: board ValkiriaSplit.kicad_pcb from below]

Board: 2 copper layers, 285.5 x 93.5 mm, 270 parts (214 on the bottom side), 173 nets.
