DavidMolTor/ValkiriaSplit/(commit log)

2026-10-18 Initial project files
    Added the main KiCAD project files.
    Added the matrix and controller schematic files.
    Updated the main ignores and readme.
    [Control_Left.kicad_sch, Control_Right.kicad_sch, Matrix_Left.kicad_sch, Matrix_Right.kicad_sch, ValkiriaSplit.kicad_pcb, ValkiriaSplit.kicad_sch]
2026-10-18 Schematic review
    Initial shcematic iteration.
    Added all footprints and part numbers.
    Only a quick review was performed.
    [Control_Left.kicad_sch, Control_Right.kicad_sch, Matrix_Left.kicad_sch, Matrix_Right.kicad_sch, ValkiriaSplit.kicad_pcb]
2026-10-18 Net configurations
    Added net labels.
    Updated the PCB components.
    [Control_Left.kicad_sch, Control_Right.kicad_sch, Matrix_Left.kicad_sch, Matrix_Right.kicad_sch, ValkiriaSplit.kicad_pcb]
2026-10-19 Initial layout
    Configured the switch and LED initial layout.
    Need to add the capacitors for the LEDs and the diodes for the switches.
    [Control_Left.kicad_sch, Control_Right.kicad_sch, Matrix_Left.kicad_sch, Matrix_Right.kicad_sch, ValkiriaSplit.kicad_pcb]
2026-10-19 Diode and LED layout
    Updated the layout for the LEDs and the diodes.
    Need to decide on a final layout for the extra keys and encoders.
    [ValkiriaSplit.kicad_pcb]
2026-10-19 Pin adjustment
    Adjusted the pins for the encoders and other.
    Now the battery measuring pin connected to an internal ADC on the XIAO nRF52840 also serves to read the rotation of the encoders.
    Attention should be put as how to implement the BAT voltage measuring to check if the encoder is turning at the same time.
    [Control_Left.kicad_sch, Control_Right.kicad_sch, Matrix_Left.kicad_sch, Matrix_Right.kicad_sch]
2026-10-19 Layout coordination
    Coordinated the layout with the schematic.
    Finished the initial switch layout.
    Need to decide on a complete layout for the keyboard and assign the auxiliary keys.
    [Control_Left.kicad_sch, Matrix_Left.kicad_sch, Matrix_Right.kicad_sch, ValkiriaSplit.kicad_pcb, ValkiriaSplit.kicad_sch]
2026-10-20 Key matrix and edges
    Defined the key matrix locations and the board edges.
    Next step: start routing and verify the buck converter layout.
    [Control_Left.kicad_sch, Control_Right.kicad_sch, Matrix_Left.kicad_sch, Matrix_Right.kicad_sch, ValkiriaSplit.kicad_pcb]
2026-10-21 Pinout and footprints
    Updated the MCU footprints because the silkscreen was too close to the edge.
    Updated the pinout for the MCUs. The left side seems to be ok, but the right side may need some adjustments.
    [Control_Left.kicad_sch, Control_Right.kicad_sch, Matrix_Left.kicad_sch, Matrix_Right.kicad_sch, ValkiriaSplit.kicad_pcb]
2026-10-22 Reset button and LED switch
    Added an LED power switch.
    Returned the reset button for bootloader access.
    Focus on changing the display to an e-ink one for lower power consumption.
    [Control_Left.kicad_sch, Control_Right.kicad_sch, Matrix_Left.kicad_sch, Matrix_Right.kicad_sch, ValkiriaSplit.kicad_pcb]
2026-10-23 MIP display and LED enable
    Return of the LED enable via GPIO.
    Changed the TFT display for a MPI panel. It's more expensive than an e-ink one, but the sharpness is really nice.
    Need to remove the numbers row to go for a true Corne-ish layout.
    [Control_Left.kicad_sch, Control_Right.kicad_sch, Matrix_Left.kicad_sch, Matrix_Right.kicad_sch, ValkiriaSplit.kicad_pcb]
2026-10-23 Row removal and key layout
    Removed the number row.
    Adjusted the spacebar position and changed it to 1u.
    Need to consider what to do for one of the halfs if its screen is to be removed.
    [Control_Left.kicad_sch, Control_Right.kicad_sch, Matrix_Left.kicad_sch, Matrix_Right.kicad_sch, ValkiriaSplit.kicad_pcb]
2026-10-26 Debug connector
    Updated the debug connector for a custom one.
    [Control_Left.kicad_sch, Control_Right.kicad_sch, Matrix_Left.kicad_sch, Matrix_Right.kicad_sch, ValkiriaSplit.kicad_pcb]
2026-10-28 Board outline and routing
    Enlarged the board outline by 0.5mm for proper fitment of the switch receptacles.
    Updated the footprint for the switch receptacles.
    Changed the JTAG connector for a custom one.
    Need to review the size of the PCB area dedicated to the MCU and the screen.
    Need to consider removing the additional reset button.
    [Control_Left.kicad_sch, Control_Right.kicad_sch, Matrix_Left.kicad_sch, Matrix_Right.kicad_sch, ValkiriaSplit.kicad_pcb, ValkiriaSplit.kicad_sch]
2026-10-29 Layout and routing
    Updated the position of some RGB LEDs.
    Routed the left side columns.
    This is a temporary commit in order to test different LED routing.
    [ValkiriaSplit.kicad_pcb]
2026-10-29 Display model and layout
    Updated the 3D model and footprint for the MIP display. It now sits further from the PCB.
    Continued the layout and routing of the left side PCB.
    [Control_Left.kicad_sch, Control_Right.kicad_sch, ValkiriaSplit.kicad_pcb]
2026-10-31 Matrix routing and data lines
    Routed some of the lines for the switch matrix.
    Routed the singal lines for the MIP display.
    Need to check clearenaces and spacing between the SPI lines.
    [Control_Left.kicad_sch, Control_Right.kicad_sch, Matrix_Left.kicad_sch, Matrix_Right.kicad_sch, ValkiriaSplit.kicad_pcb]
2026-11-04 Power routing and SPI pins
    Changed the SPI pins for the display, allowing for more direct routing.
    Finished the routing of the power lines for the left side.
    Need to reconsider how to connect the switch matrix lines to the MCU.
    [Control_Left.kicad_sch, ValkiriaSplit.kicad_pcb]
2026-11-10 PCB layout and readme
    Minimal changes to the PCB layout.
    Updated the readme and added a more recent PCB view for the description.
    [Control_Left.kicad_sch, ValkiriaSplit.kicad_pcb]
2026-11-10 Readme picture location
    Updated the location of the PCB picture in the description.
2026-11-13 Right side pinout and power routing
    Updated the pinout for the right MCU.
    Routed the power lines and the LED regulator for the right side.
    Next step, route the switch matrix for the right side.
    Reset switches might need to be removed.
    [Control_Left.kicad_sch, Control_Right.kicad_sch, Matrix_Left.kicad_sch, Matrix_Right.kicad_sch, ValkiriaSplit.kicad_pcb]
